retrospy/CHESSmate-Reproduction/PCB/CHESSmate CPU-ESP/CHESSmate CPU.kicad_pcb

## KiCad design PCB/CHESSmate CPU-ESP/CHESSmate CPU.kicad_pcb (2024-08-03)

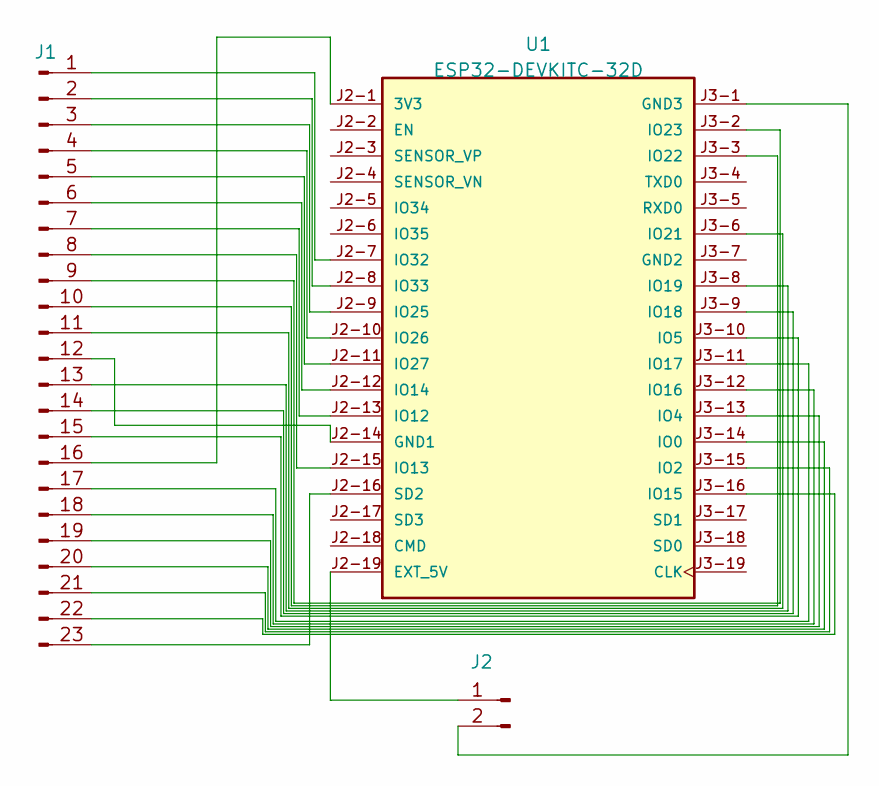
[picture p1: schematic CHESSmate CPU.kicad_sch]

Parts:
J1: Conn_01x22_Pin; PinHeader_1x23_P2.54mm_Vertical
J2: Conn_01x02_Pin; PinHeader_1x02_P2.54mm_Vertical
U1: ESP32-DEVKITC-32D; MODULE_ESP32-DEVKITC-32D; PARTREV V4

Connections:
unnamed: J1.1, U1.J2-7 (IO32)
unnamed: J1.2, U1.J2-8 (IO33)
unnamed: J1.3, U1.J2-9 (IO25)
unnamed: J1.4, U1.J2-10 (IO26)
unnamed: J1.5, U1.J2-11 (IO27)
unnamed: J1.6, U1.J2-12 (IO14)
unnamed: J1.7, U1.J2-13 (IO12)
unnamed: J1.8, U1.J2-15 (IO13)
unnamed: J1.9, U1.J3-2 (IO23)
unnamed: J1.10, U1.J3-3 (IO22)
unnamed: J1.11, U1.J3-6 (IO21)
unnamed: J1.12, U1.J2-14 (GND1)
unnamed: J1.13, U1.J3-8 (IO19)
unnamed: J1.14, U1.J3-9 (IO18)
unnamed: J1.15, U1.J3-10 (IO5)
unnamed: J1.16, U1.J2-1 (3V3)
unnamed: J1.17, U1.J3-11 (IO17)
unnamed: J1.18, U1.J3-12 (IO16)
unnamed: J1.19, U1.J3-13 (IO4)
unnamed: J1.20, U1.J3-14 (IO0)
unnamed: J1.21, U1.J3-15 (IO2)
unnamed: J1.22, U1.J3-16 (IO15)
unnamed: J1.23, U1.J2-16 (SD2)
unnamed: J2.1, U1.J2-19 (EXT_5V)
unnamed: J2.2, U1.J3-1 (GND3)

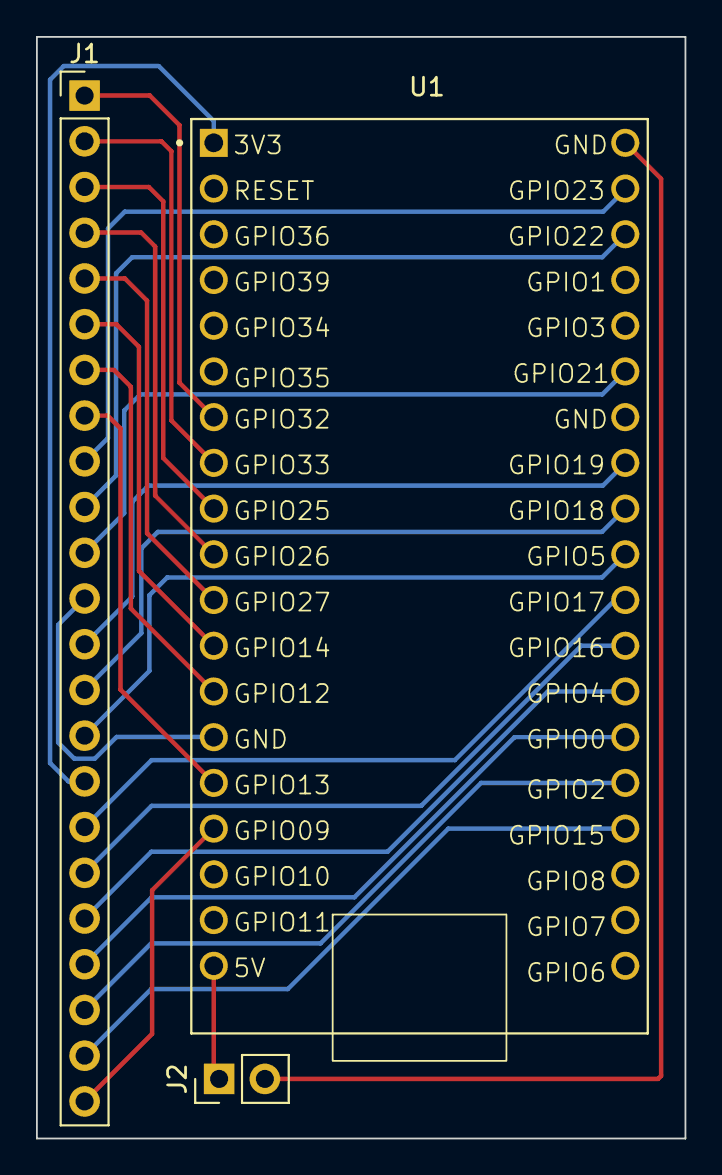
[picture p2: board CHESSmate CPU.kicad_pcb from above]

Board: 2 copper layers, 36.0 x 61.2 mm, 3 parts (0 on the bottom side), 25 nets.
