retrospy/CHESSmate-Reproduction/PCB/CHESSmate PCB.kicad_pcb

## KiCad design PCB/CHESSmate PCB.kicad_pcb (2024-08-03)

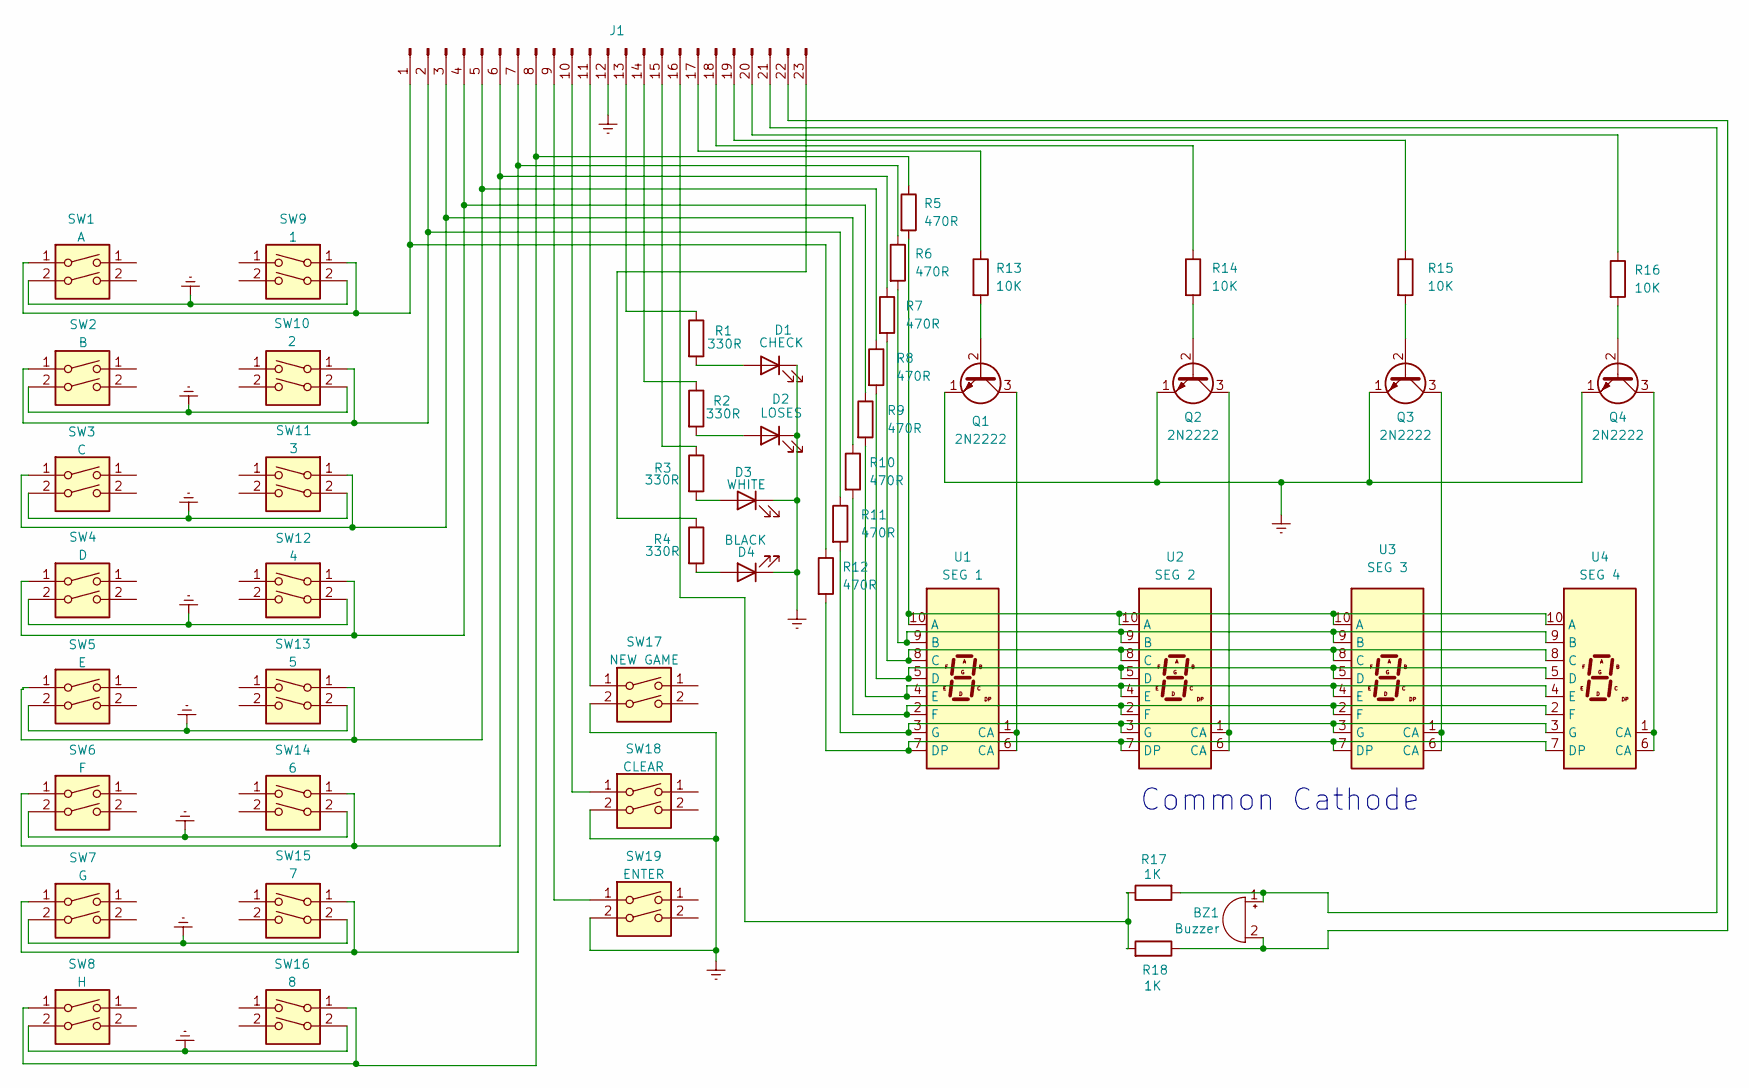
[picture p3: schematic CHESSmate PCB.kicad_sch, CHESSmate Membrane]

Parts:
BZ1: Buzzer; Buzzer_12x9.5RM7.6
D1: CHECK; LED_D5.0mm
D2: LOSES; LED_D5.0mm
D3: WHITE; LED_D5.0mm
D4: BLACK; LED_D5.0mm
J1: PinHeader_1x23_P2.54mm_Vertical
Q1, Q2, Q3, Q4: 2N2222; TO-92_Inline
R1, R2, R3, R4: 330R; R_Axial_DIN0207_L6.3mm_D2.5mm_P10.16mm_Horizontal
R5, R6, R7, R8, R9, R10, R11, R12: 470R; R_Axial_DIN0207_L6.3mm_D2.5mm_P10.16mm_Horizontal
R13, R14, R15, R16: 10K; R_Axial_DIN0207_L6.3mm_D2.5mm_P10.16mm_Horizontal
R17, R18: 1K; R_Axial_DIN0207_L6.3mm_D2.5mm_P10.16mm_Horizontal
SW1: A; SW_PUSH-12mm_Wuerth-430476085716
SW2: B; SW_PUSH-12mm_Wuerth-430476085716
SW3: C; SW_PUSH-12mm_Wuerth-430476085716
SW4: D; SW_PUSH-12mm_Wuerth-430476085716
SW5: E; SW_PUSH-12mm_Wuerth-430476085716
SW6: F; SW_PUSH-12mm_Wuerth-430476085716
SW7: G; SW_PUSH-12mm_Wuerth-430476085716
SW8: H; SW_PUSH-12mm_Wuerth-430476085716
SW9: 1; SW_PUSH-12mm_Wuerth-430476085716
SW10: 2; SW_PUSH-12mm_Wuerth-430476085716
SW11: 3; SW_PUSH-12mm_Wuerth-430476085716
SW12: 4; SW_PUSH-12mm_Wuerth-430476085716
SW13: 5; SW_PUSH-12mm_Wuerth-430476085716
SW14: 6; SW_PUSH-12mm_Wuerth-430476085716
SW15: 7; SW_PUSH-12mm_Wuerth-430476085716
SW16: 8; SW_PUSH-12mm_Wuerth-430476085716
SW17: NEW GAME; SW_PUSH-12mm
SW18: CLEAR; SW_PUSH-12mm_Wuerth-430476085716
SW19: ENTER; SW_PUSH-12mm_Wuerth-430476085716
U1: SEG 1; HDSP-A151
U2: SEG 2; HDSP-A151
U3: SEG 3; HDSP-A151
U4: SEG 4; HDSP-A151

Connections:
GNDREF: D1.1 (K), D2.1 (K), D3.1 (K), D4.1 (K), J1.12, Q1.1 (E), Q2.1 (E), Q3.1 (E), Q4.1 (E), SW1.2, SW2.2, SW3.2, SW4.2, SW5.2, SW6.2, SW7.2, SW8.2, SW9.2 (`), SW10.2, SW11.2, SW12.2, SW13.2, SW14.2, SW15.2, SW16.2, SW17.2, SW18.2, SW19.2
unnamed: BZ1.2 (+), J1.22, R18.1
unnamed: BZ1.1 (-), J1.21, R17.2
unnamed: D1.2 (A), R1.2
unnamed: D2.2 (A), R2.2
unnamed: D3.2 (A), R3.2
unnamed: D4.2 (A), R4.2
unnamed: J1.1, R12.1, SW1.1, SW9.1
unnamed: J1.2, R11.1, SW2.1, SW10.1
unnamed: J1.3, R10.1, SW3.1, SW11.1
unnamed: J1.4, R9.1, SW4.1, SW12.1
unnamed: J1.5, R8.1, SW5.1, SW13.1
unnamed: J1.6, R7.1, SW6.1, SW14.1
unnamed: J1.7, R6.1, SW7.1, SW15.1
unnamed: J1.8, R5.1, SW8.1, SW16.1
unnamed: J1.9, SW19.1
unnamed: J1.10, SW18.1
unnamed: J1.11, SW17.1
unnamed: J1.13, R1.1
unnamed: J1.14, R2.1
unnamed: J1.15, R3.1
unnamed: J1.16, R17.1, R18.2
unnamed: J1.17, R13.1
unnamed: J1.18, R14.1
unnamed: J1.19, R15.1
unnamed: J1.20, R16.1
unnamed: J1.23, R4.1
unnamed: Q1.2 (B), R13.2
unnamed: Q1.3 (C), U1.1 (CA), U1.6 (CA)
unnamed: Q2.2 (B), R14.2
unnamed: Q2.3 (C), U2.1 (CA), U2.6 (CA)
unnamed: Q3.2 (B), R15.2
unnamed: Q3.3 (C), U3.1 (CA), U3.6 (CA)
unnamed: Q4.2 (B), R16.2
unnamed: Q4.3 (C), U4.1 (CA), U4.6 (CA)
unnamed: R5.2, U1.10 (A), U2.10 (A), U3.10 (A), U4.10 (A)
unnamed: R6.2, U1.9 (B), U2.9 (B), U3.9 (B), U4.9 (B)
unnamed: R7.2, U1.8 (C), U2.8 (C), U3.8 (C), U4.8 (C)
unnamed: R8.2, U1.5 (D), U2.5 (D), U3.5 (D), U4.5 (D)
unnamed: R12.2, U1.7 (DP), U2.7 (DP), U3.7 (DP), U4.7 (DP)
unnamed: R9.2, U1.4 (E), U2.4 (E), U3.4 (E), U4.4 (E)
unnamed: R10.2, U1.2 (F), U2.2 (F), U3.2 (F), U4.2 (F)
unnamed: R11.2, U1.3 (G), U2.3 (G), U3.3 (G), U4.3 (G)

Notes on the sheet:
Common Cathode

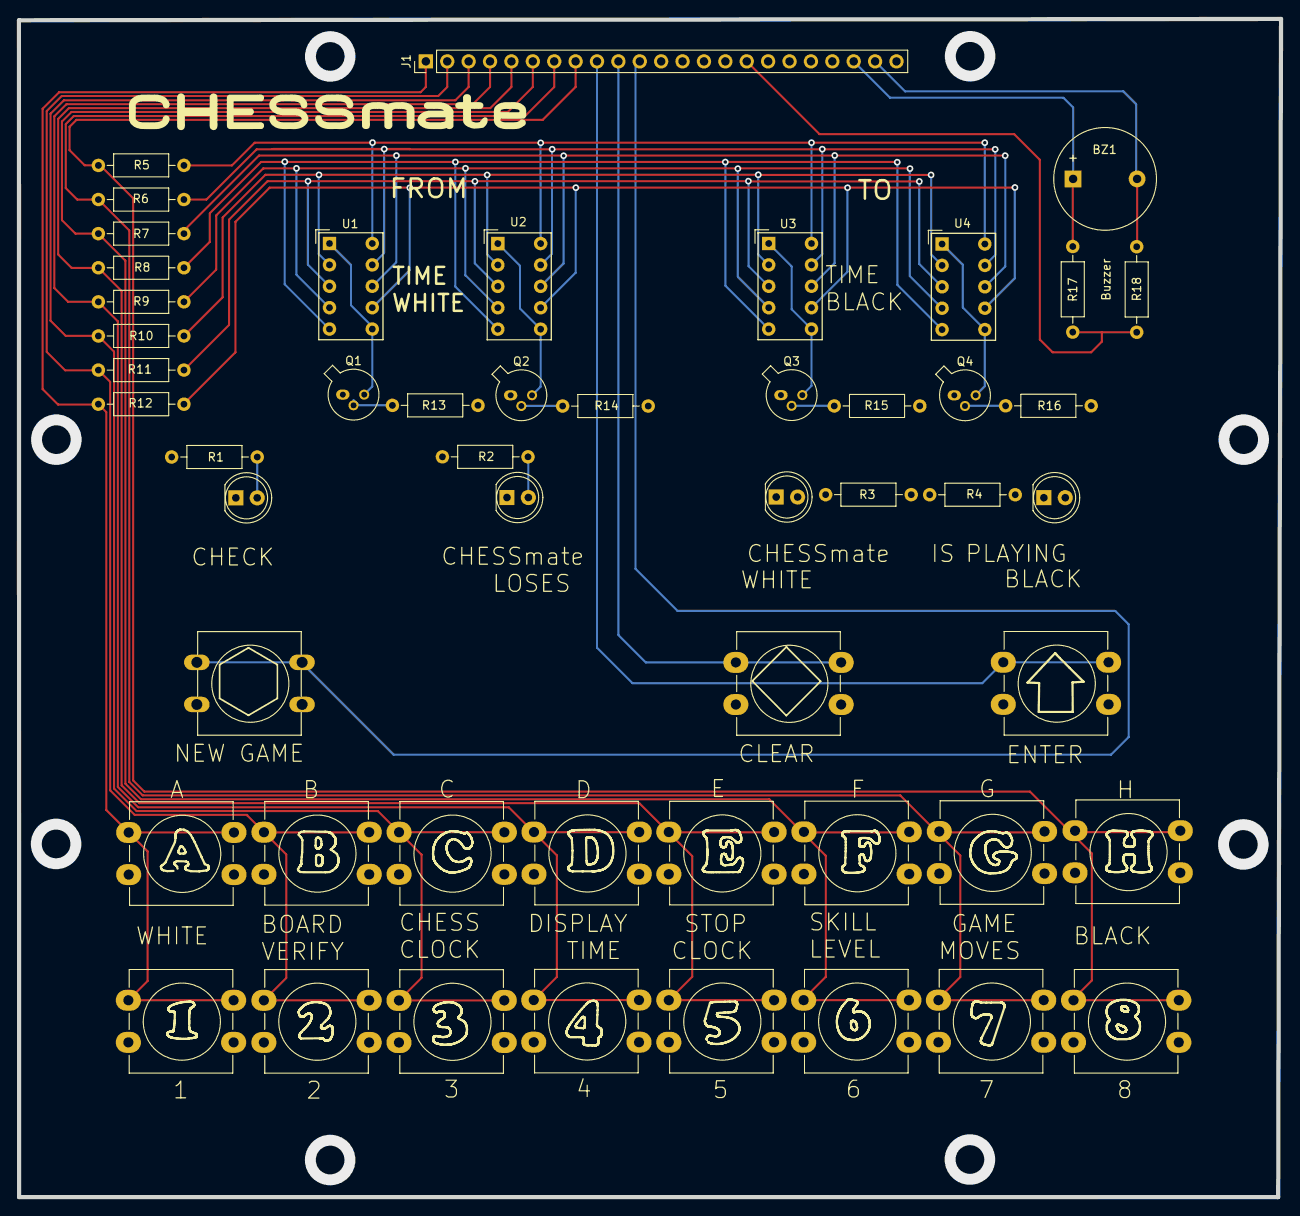
[picture p4: board CHESSmate PCB.kicad_pcb from above]

Board: 4 copper layers, 149.8 x 139.9 mm, 51 parts (0 on the bottom side), 43 nets.
