retrospy/CHESSmate-Reproduction/PCB/CHESSmate CPU-Pico/CHESSmate CPU.brd

## EAGLE design PCB/CHESSmate CPU-Pico/CHESSmate CPU.brd (2024-08-03)

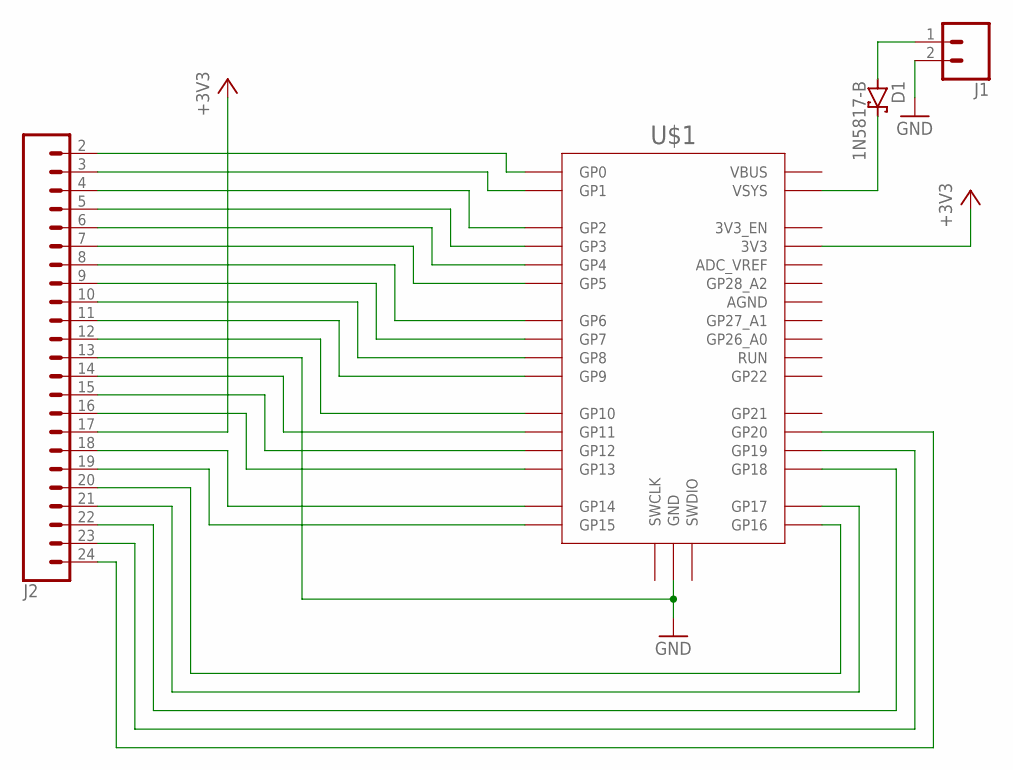
[picture p5: schematic CHESSmate CPU.sch]

Parts:
D1: 1N5817-B; DO41-7.6
J1: CONN_02; 1X02
J2: CONN_23; 1X23
U$1: RPI_PICO-TH; RPI_PICO_TH

Connections:
+3V3: J2.17, U$1.3V3
GND: J1.2, J2.13, U$1.GND@1 (GND), U$1.GND@2 (GND), U$1.GND@3 (GND), U$1.GND@4 (GND), U$1.GND@5 (GND), U$1.GND@6 (GND), U$1.GND@7 (GND), U$1.GND@8 (GND)
unnamed: D1.C, U$1.VSYS
unnamed: D1.A, J1.1
unnamed: J2.2, U$1.GP0
unnamed: J2.3, U$1.GP1
unnamed: J2.4, U$1.GP2
unnamed: J2.5, U$1.GP3
unnamed: J2.6, U$1.GP4
unnamed: J2.7, U$1.GP5
unnamed: J2.8, U$1.GP6
unnamed: J2.9, U$1.GP7
unnamed: J2.10, U$1.GP8
unnamed: J2.11, U$1.GP9
unnamed: J2.14, U$1.GP11
unnamed: J2.12, U$1.GP10
unnamed: J2.15, U$1.GP12
unnamed: J2.20, U$1.GP16
unnamed: J2.21, U$1.GP17
unnamed: J2.16, U$1.GP13
unnamed: J2.18, U$1.GP14
unnamed: J2.19, U$1.GP15
unnamed: J2.22, U$1.GP18
unnamed: J2.23, U$1.GP19
unnamed: J2.24, U$1.GP20

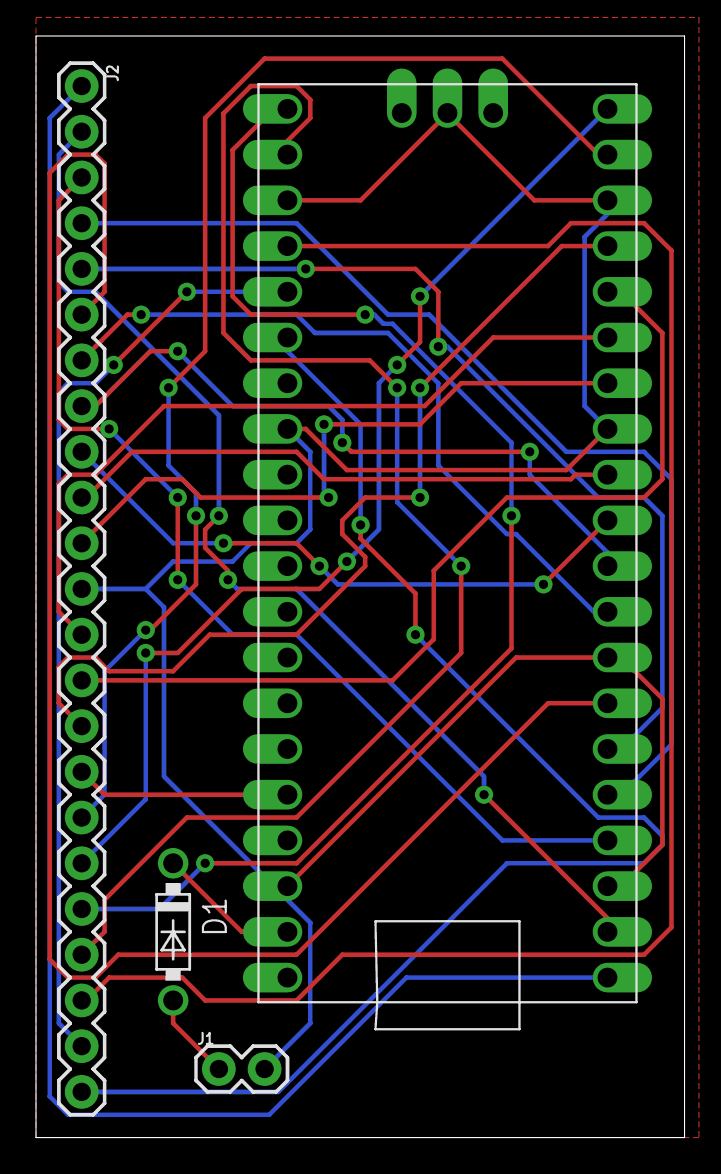
[picture p6: board CHESSmate CPU.brd from above]

Board: 2 copper layers, 36.0 x 61.2 mm, 4 parts (0 on the bottom side), 25 nets.
