retrospy/CHESSmate-Reproduction/Firmware/CHESSmate_ESP32/CHESSmate_ESP32.ino

/** CHESSmate emulator for Arduino.
 *  
 *  The 6502 emulator is from Mike Chambers.
 *
 *    http://forum.arduino.cc/index.php?topic=193216.0
 *
 *  Project inspired by Oscar Vermeulen's KIM-1 Uno project.
 *
 *    https://obsolescence.wixsite.com/obsolescence/kim-uno-summary-c1uuh
 *
 *  CHESSmate code added by Michael Gardi.
 *
 *    https://hackaday.io/project/194011-commodore-chessmate-reproduction
 *
 *  This Sketch is specifically for the ESP32 WROOM.
 */
#define SAD     0     // 6530 A DATA
#define PADD    1     // 6530 A DATA DIRECTION
#define SBD     2     // 6530 B DATA
#define PBDD    3     // 6530 B DATA DIRECTION
#define CLK1T   4     // DIV BY 1 TIME Read timer disable interrupt 
#define CLKRDT  6     // READ TIMER
#define CLKRDI  7     // READ TIMEOUT BIT
#define CKINT   14    // Read timer interrupt
#define CLKTI   15    // DIV by 1024 enable interrupts

#if defined(RASPBERRYPI_PICO) || defined(ARDUINO_RASPBERRY_PI_PICO)
// IO pins used on the arduino.
#define PA0 7
#define PA1 6
#define PA2 5
#define PA3 4
#define PA4 3
#define PA5 2
#define PA6 1
#define PA7 0

#define ENTER_KEY     8
#define CLEAR_KEY     9
#define NEW_GAME_KEY  10

#define CHECK_LED     11
#define LOSES_LED     12
#define WHITE_LED     13
#define BLACK_LED     20

#define DISPLAY_1     14
#define DISPLAY_2     15
#define DISPLAY_3     16
#define DISPLAY_4     17

#define BUZZER_1      18
#define BUZZER_2      19
#else
// IO pins used on the arduino.
#define PA0 13
#define PA1 12
#define PA2 14
#define PA3 27
#define PA4 26
#define PA5 25
#define PA6 33
#define PA7 32

#define ENTER_KEY     23
#define CLEAR_KEY     22
#define NEW_GAME_KEY  21

#define CHECK_LED     19
#define LOSES_LED     18
#define WHITE_LED     5
#define BLACK_LED     9

#define DISPLAY_1     17
#define DISPLAY_2     16
#define DISPLAY_3     4
#define DISPLAY_4     0

#define BUZZER_1      2
#define BUZZER_2      15
#endif

// Millisecond value for 1 minute.
#define PART_MINUTE   250   // 1/240th of a minute in millseconds.

// Keep track of what "virtual" keyboard row has been enabled.
int keyboard_row = 0;

// Remember what the last write to the SBC (B data port) was.
uint8_t sbc_value = 0;

// When this value is non-zero generate an interrupt after one minute passes.
unsigned long int_start = 0;

// This is the interrupt flag. 0x00 if no interrupt, 0x80 if interrupt has been triggered.
uint8_t int_flag = 0;

extern "C" { 
  void exec6502(int32_t tickcount);
  void reset6502();
  void irq6502();
  uint16_t getpc();
}

void setup () {
  Serial.begin (115200);
#if defined(RASPBERRYPI_PICO) || defined(ARDUINO_RASPBERRY_PI_PICO)
  delay(1000);
#else
  while (!Serial) {
    ; // wait for serial port to connect. Needed for native USB
  }
#endif
  delay(100);
  Serial.println ("CHESSmate Starting");
  
  // Set modes for pins that won't change.
  pinMode(NEW_GAME_KEY, INPUT_PULLUP);
  pinMode(CLEAR_KEY, INPUT_PULLUP);
  pinMode(ENTER_KEY, INPUT_PULLUP);

  pinMode(CHECK_LED, OUTPUT);
  pinMode(LOSES_LED, OUTPUT);

  pinMode(BLACK_LED, OUTPUT);
  pinMode(WHITE_LED, OUTPUT);

  pinMode(DISPLAY_1, OUTPUT);
  pinMode(DISPLAY_2, OUTPUT);
  pinMode(DISPLAY_3, OUTPUT);
  pinMode(DISPLAY_4, OUTPUT);

  pinMode(BUZZER_1, OUTPUT);
  pinMode(BUZZER_2, OUTPUT);

  // Set the program counter to the start of the CHESSmate program, set stack pointer, clear registers and flags.
  reset6502();
}

void loop () {
  // If timing is enabled, this value is in 6502 clock ticks.
  exec6502(1000);

  if (int_start > 0) {
    if ((millis() - int_start) >= PART_MINUTE) {
      int_flag = 0x80;
      irq6502();
    }
  }
}

// Required functions from the emulator C code.
extern "C" { 
  /********************************************************************************************
   *   This is the key part of the CHESSmate "emulation". Pretend to be a 6530-24 RRIOT chip.
   *
   *   Translate the reads and writes to and from the program to the 6530-24 RRIOT registers
   *   and map the bits to the actual switches, 7-segment displays, and LEDs.
   *
   ********************************************************************************************/
  // Handle reads from RRIOT registers.
  uint8_t readRRIOT(uint16_t address) {
    if (address == SBD) {             // Port B Data
      // Reading from PORTB. Return the previous value of PORTB.
      return sbc_value;
    } else if (address == SAD) {      // Port A Data
      // Check for NEW GAME. (Reset)
      if (digitalRead(NEW_GAME_KEY) == LOW) {
        reset6502();
      }
      // Default result, no keys pressed.
      uint8_t result = 0b01111111;
  
      // Checking for keypress.
      if (keyboard_row == 1) {
        if (digitalRead(PA7) == LOW) {
          result = 0b01011111;
        } else if (digitalRead(PA6) == LOW) {
          result = 0b01101111;
        } else if (digitalRead(PA5) == LOW) {
          result = 0b01110111;
        } else if (digitalRead(PA4) == LOW) {
          result = 0b01111011;
        } else if (digitalRead(PA3) == LOW) {
          result = 0b01111101;
        } else if (digitalRead(PA2) == LOW) {
          result = 0b01111110;
        }
      } else if (keyboard_row == 2) {
        if (digitalRead(PA1) == LOW) {
          result = 0b00111111;
        } else if (digitalRead(PA0) == LOW) {
          result = 0b01011111;
        } else if (digitalRead(CLEAR_KEY) == LOW) {
          result = 0b01101111;
        } else if (digitalRead(ENTER_KEY) == LOW) {
          result = 0b01110111;
        }
      }
      return result;
    } else if (address == CKINT) {
      // Read the RRIOT timer. Used to get a random number for opening moves.
      return random(0, 32);
    } else if (address == CLKRDI) {
      // Return 0x80 if the "interrupt" has been triggered, 0x00 otherwise.
      return int_flag;
    } else if (address == CLKRDT) {
      // Current value of the timer countdown?
      return 0x00;
    } 
    return 0x00;
  }

  // Handle writes to RRIOT registers.
  void writeRRIOT(uint16_t address, uint8_t value) {
    if (address == SAD) {                 // Port A Data
      // PA0 - PA7 Data Register (SAD)
      // Maps to Pro Mini pins 0 - 7
      if ((value & 0b00000001) > 0) {
        digitalWrite(PA0, HIGH);
      } else {
        digitalWrite(PA0, LOW);
      }
      if ((value & 0b00000010) > 0) {
        digitalWrite(PA1, HIGH);
      } else {
        digitalWrite(PA1, LOW);
      }
      if ((value & 0b00000100) > 0) {
        digitalWrite(PA2, HIGH);
      } else {
        digitalWrite(PA2, LOW);
      }
      if ((value & 0b00001000) > 0) {
        digitalWrite(PA3, HIGH);
      } else {
        digitalWrite(PA3, LOW);
      }
      if ((value & 0b00010000) > 0) {
        digitalWrite(PA4, HIGH);
      } else {
        digitalWrite(PA4, LOW);
      }
      if ((value & 0b00100000) > 0) {
        digitalWrite(PA5, HIGH);
      } else {
        digitalWrite(PA5, LOW);
      }
      if ((value & 0b01000000) > 0) {
        digitalWrite(PA6, HIGH);
      } else {
        digitalWrite(PA6, LOW);
      }
      if ((value & 0b10000000) > 0) {
        digitalWrite(PA7, HIGH);
      } else {
        digitalWrite(PA7, LOW);
      }
      // Check for CHESSmate LOSES.
      if ((value & 0b10000000) > 0) {
        digitalWrite(LOSES_LED, HIGH);
      } else {
        digitalWrite(LOSES_LED, LOW);
      }
    } else if (address == PADD) {          // Port A Data Direction
      // PA0 - PA7 Data Direction Register (PADD)
      if (value == 128) {
        pinMode(PA0, INPUT_PULLUP);
        pinMode(PA1, INPUT_PULLUP);
        pinMode(PA2, INPUT_PULLUP);
        pinMode(PA3, INPUT_PULLUP);
        pinMode(PA4, INPUT_PULLUP);
        pinMode(PA5, INPUT_PULLUP);
        pinMode(PA6, INPUT_PULLUP);
        pinMode(PA7, INPUT_PULLUP);
      } else {
        pinMode(PA0, OUTPUT);
        pinMode(PA1, OUTPUT);
        pinMode(PA2, OUTPUT);
        pinMode(PA3, OUTPUT);
        pinMode(PA4, OUTPUT);
        pinMode(PA5, OUTPUT);
        pinMode(PA6, OUTPUT);
        pinMode(PA7, OUTPUT);;
      }
    } else if (address == SBD) {          // Port B Data
      // PB0 - PB7 Data Register (SBD)
      // Remember the last value written to this register.
      sbc_value = value;
  
      // The bottom 3 bits of the value control 8 IO lines. Only 1 will be turned on.
      digitalWrite(DISPLAY_1, LOW);
      digitalWrite(DISPLAY_2, LOW);
      digitalWrite(DISPLAY_3, LOW);
      digitalWrite(DISPLAY_4, LOW);
      keyboard_row = 0;
      digitalWrite(BUZZER_1, LOW);
      digitalWrite(BUZZER_2, LOW);
  
      // Determine which line to enable.
      switch (value & 0x07) {
        case 0:
          digitalWrite(DISPLAY_1, HIGH);
          break;
        case 1:
          digitalWrite(DISPLAY_2, HIGH);
          break;
        case 2:
          digitalWrite(DISPLAY_3, HIGH);
          break;
        case 3:
          digitalWrite(DISPLAY_4, HIGH);
          break;
        case 4:
          keyboard_row = 1;
          break;
        case 5:
          keyboard_row = 2;
          break;
        case 6:
          digitalWrite(BUZZER_1, HIGH);
          break;
        case 7:
          digitalWrite(BUZZER_2, HIGH);
          break;
        default:
          break;
      }
      // Check for CHECK.
      if ((value & 0b00001000) > 0) {
          digitalWrite(CHECK_LED, HIGH);
      } else {
          digitalWrite(CHECK_LED, LOW);
      }
      
      // Check for BLACK or WHITE.
      if ((value & 0b00010000) > 0) {
        digitalWrite(BLACK_LED, LOW);
        digitalWrite(WHITE_LED, HIGH);
      } else {
        digitalWrite(BLACK_LED, HIGH);
        digitalWrite(WHITE_LED, LOW);
      }
    } else if (address == PBDD) {            // Port B Data Direction
      // PB0 - PB7 Data Direction Register (PBDD)
      // Does not directly map to specific pins. Will always be output. 0x7F
    } else if (address == CLKTI) {
      // Restart timer interrupt. 
      int_start = millis();
      int_flag = 0;
    } else if (address == CLK1T) {
      // Disable interrupts.
      int_start = 0;
    } 
  }
  extern "C" { 
    void printhex(uint16_t val) {
      Serial.print(val, HEX);
      Serial.print(" ");
      Serial.print(val);
      Serial.println();
    }
    void print_instruction(char r_w, uint16_t pc, uint16_t address, uint8_t val) {
      Serial.print(r_w);
      Serial.print(" ");
      Serial.print(pc,HEX);
      Serial.print(" ");
      Serial.print(address,HEX);
      Serial.print(" ");
      Serial.print(val,HEX);
      Serial.println();
    }
  }
} 
