retrospy/CHESSmate-Reproduction/(commit log)

2024-08-03 23 pin CPU connector
    This doesn't work because you can't use GPIO6, so I designed a new CPU board with a Pi Pico
    [CHESSmate CPU.kicad_pcb, CHESSmate CPU.kicad_sch, CHESSmate PCB.kicad_pcb, CHESSmate PCB.kicad_sch]
2024-08-03 Updated Fabrication files
    [CHESSmate CPU-B_Cu.gbl, CHESSmate CPU-B_Mask.gbs, CHESSmate CPU-B_Paste.gbp, CHESSmate CPU-B_Silkscreen.gbo, CHESSmate CPU-Edge_Cuts.gm1, CHESSmate CPU-F_Cu.gtl, CHESSmate CPU-F_Mask.gts, CHESSmate CPU-F_Paste.gtp]
2024-08-03 Seperated the CPU into an ESP version and Pico Version
    [CHESSmate CPU-B_Cu.gbl, CHESSmate CPU-B_Mask.gbs, CHESSmate CPU-B_Paste.gbp, CHESSmate CPU-B_Silkscreen.gbo, CHESSmate CPU-Edge_Cuts.gm1, CHESSmate CPU-F_Cu.gtl, CHESSmate CPU-F_Mask.gts, CHESSmate CPU-F_Paste.gtp]
